mohammadhgh/EVent-ir/Images/v0_1_mit_ir/3D_render_2.jpeg

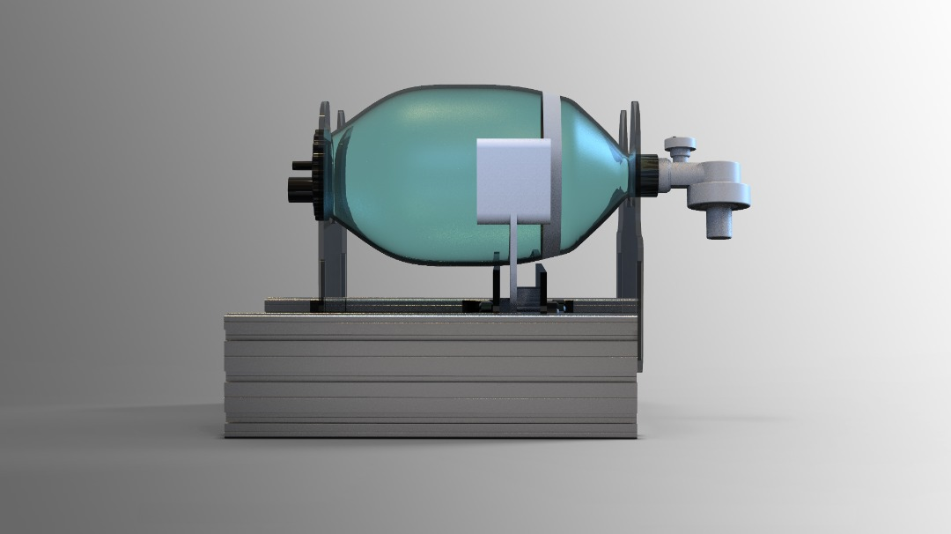
Images/v0_1_mit_ir/3D_render_2.jpeg
