mohammadhgh/EVent-ir/README.md

# EVent-ir
COVID-19 Open Source Emergency Ventilator (ir version)
