mohammadhgh/EVent-ir/Design/ColorPalette.png

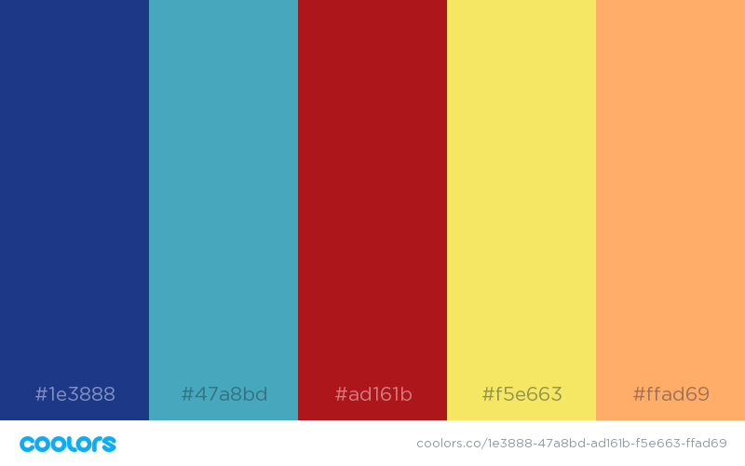
Design/ColorPalette.png
