mohammadhgh/EVent-ir/Mechanical/E-Vent Solidworks v1.0/BOM/BOM.docx

لیست خرید و تخمین قیمت

تعداد | قیمت واحد (ت) | نام قطعه | 1
2 | 78524 | شفت هارد با قطر 12 میلی‌متر طول 62 میلی‌متر (https://www.sanatbazar.com/shop/shop-main/%D8%B4%D9%81%D8%AA-%D9%87%D8%A7%D8%B1%D8%AF-%D8%A8%D8%A7-%D9%82%D8%B7%D8%B1-12-%D9%85%DB%8C%D9%84%DB%8C%D9%85%D8%AA%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) | 2
1 | 66445 | شفت هارد با قطر 12 میلی متر طول 50.5 میلی‌متر (https://www.sanatbazar.com/shop/shop-main/%D8%B4%D9%81%D8%AA-%D9%87%D8%A7%D8%B1%D8%AF-%D8%A8%D8%A7-%D9%82%D8%B7%D8%B1-12-%D9%85%DB%8C%D9%84%DB%8C%D9%85%D8%AA%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) | 3
2 | 37650 | پروفیل آلومینیومی شیاردار 30در90 به طول 300 میلی‌متر (https://www.sanatbazar.com/shop/shop-main/%D9%BE%D8%B1%D9%88%D9%81%DB%8C%D9%84-%D8%A2%D9%84%D9%88%D9%85%DB%8C%D9%86%DB%8C%D9%88%D9%85%DB%8C-30-90) | 4
10 | 7151 | نبشی پروفیل دیواره دار (لچکی دار) بدون پرداخت سطح 30 در 30 و مناسب برای اسلات 8 (https://www.sanatbazar.com/shop/shop-main/%D8%A7%D8%AA%D8%B5%D8%A7%D9%84-%D8%B2%D8%A7%D9%88%DB%8C%D9%87-%D8%AF%D8%A7%D8%B1-angle-connector-%D9%85%D9%86%D8%A7%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) | 5
5 | 25049 | بست شفت مدل RSB با قطر 12 میلی متر (https://www.sanatbazar.com/shop/shop-main/%D8%A8%D8%B3%D8%AA-%D8%B4%D9%81%D8%AA-%D9%85%D8%AF%D9%84-rsb-%D8%A8%D8%A7-%D9%82%D8%B7%D8%B1%D9%87%D8%A7%DB%8C-%D9%8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) | 6
3 | 92843 | چرخ دنده ساده فلنج‌دار مدول 1.5 با تعداد دندانه های 30 (https://www.sanatbazar.com/shop/shop-main/%DA%86%D8%B1%D8%AE%D8%AF%D9%86%D8%AF%D9%87-%D8%B3%D8%A7%D8%AF%D9%87-%D9%81%D9%84%D9%86%D8%AC-%D8%AF%D8%A7%D8%B1-%D9%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) | 7
10 | | پیچ M3x20 و مهره | 8
10 | | پیچ M3x10 و مهره | 9
24 | | پیچ M8x16 و مهره | 10

هزینه ماشین CNC

هزینه خرید ورق آلومینیومی
