mohammadhgh/EVent-ir/Mechanical/E-Vent Solidworks v2.1/E-Vent v2.0.SLDASM

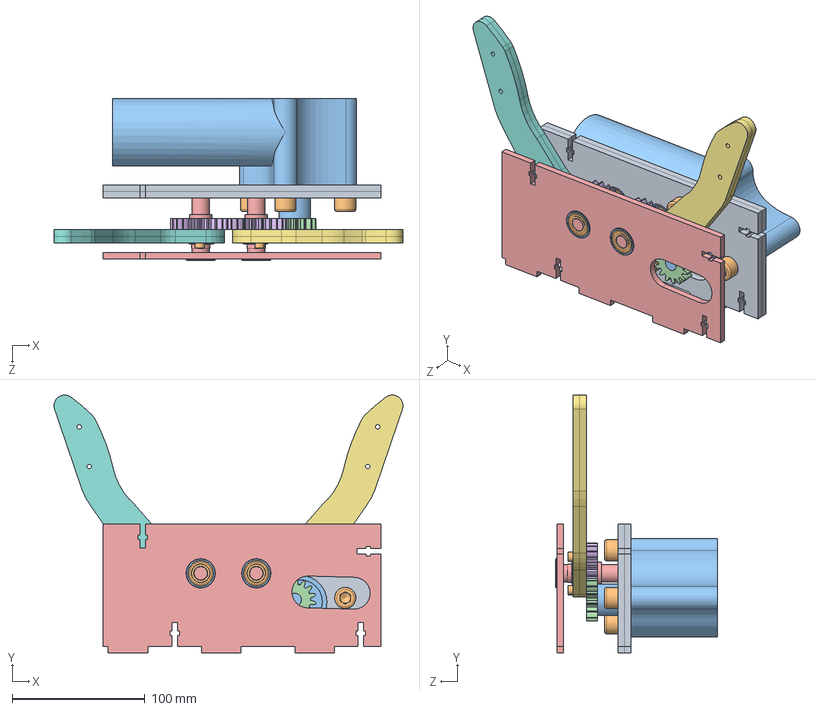
[picture p7: CAD file, 2020-04-24]
Mechanical/E-Vent Solidworks v2.1/E-Vent v2.0.SLDASM
263.1 x 194.3 x 121.8 mm
Motor and Finger Mount v2.0 x 2
_61900_2Z_PART1_2 x 4
_61900_2Z_PART2_4 x 4
_61900_2Z_PART3_6 x 36
shaft 10 mm x 2
ISO - Spur gear 1.9M 22T 20PA 8.4FW ---S22A75H50L14.0N x 2
Finger x 2
Finger 2 x 2
circlip for shafts normal_din x 2
socket head cap screw_iso x 7
Buhler motor
spur gear_iso
Motor and Finger Mount 2 v2.0
