mohammadhgh/EVent-ir/Mechanical/E-Vent Solidworks v2.1/Motor and Finger Mount v2.0.SLDPRT

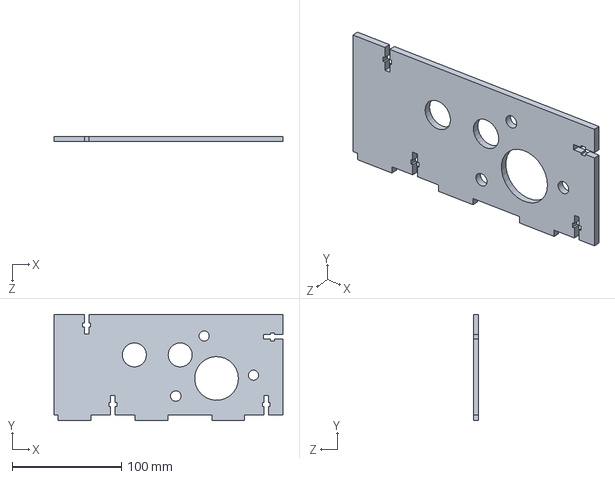
[picture p8: CAD file, 2020-04-24]
Mechanical/E-Vent Solidworks v2.1/Motor and Finger Mount v2.0.SLDPRT
209.5 x 97.0 x 5.00 mm
