mohammadhgh/EVent-ir/Mechanical/E-Vent Solidworks v2.1/Finger 2.SLDPRT

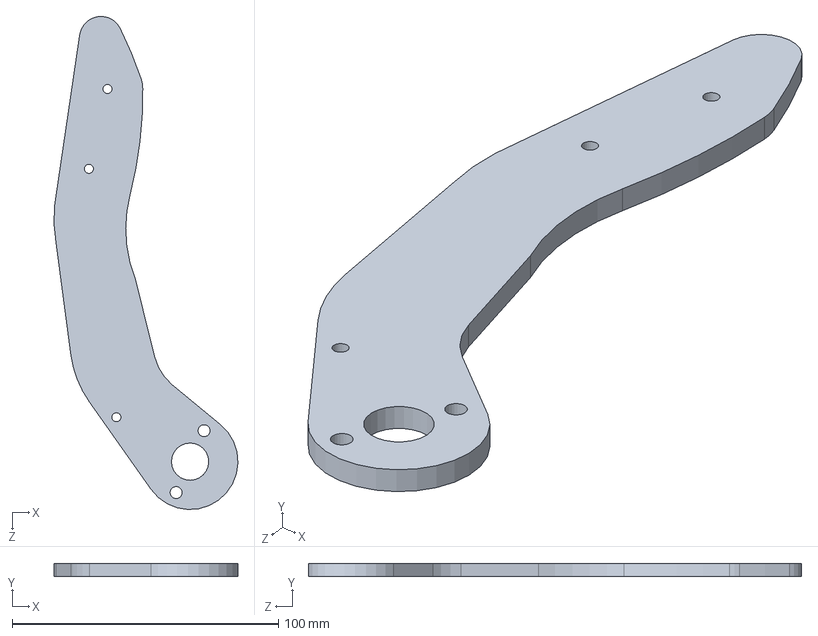
[picture p9: CAD file, 2020-04-24]
Mechanical/E-Vent Solidworks v2.1/Finger 2.SLDPRT
69.1 x 5.00 x 185.2 mm
