mohammadhgh/EVent-ir/Mechanical/E-Vent Solidworks v2.1/shaft 10 mm.SLDPRT

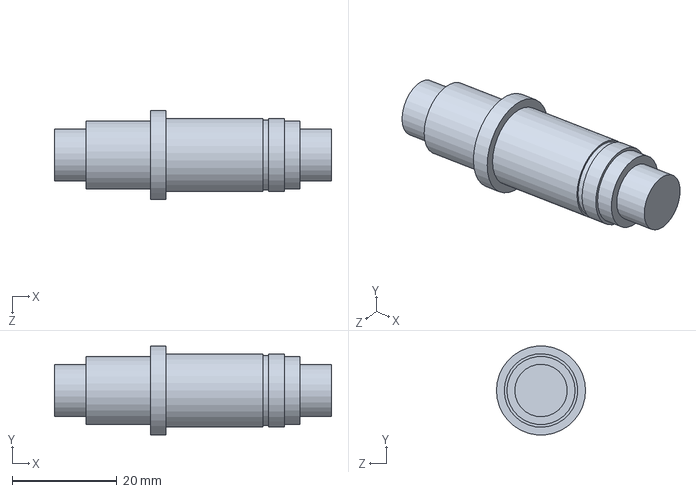
[picture p10: CAD file, 2020-04-24]
Mechanical/E-Vent Solidworks v2.1/shaft 10 mm.SLDPRT
52.8 x 16.9 x 17.0 mm
