mohammadhgh/EVent-ir/Mechanical/E-Vent Solidworks v2.1/Buhler motor.SLDPRT

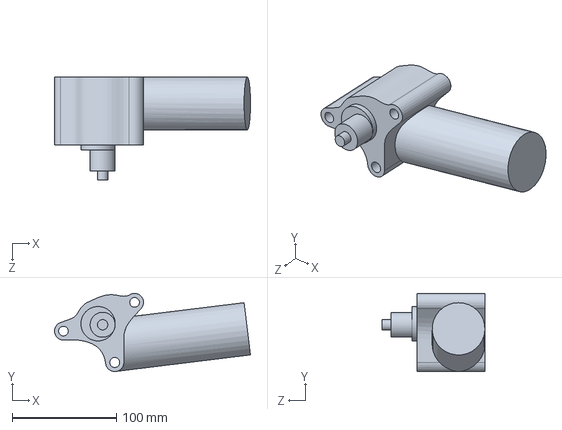
[picture p11: CAD file, 2020-04-14]
Mechanical/E-Vent Solidworks v2.1/Buhler motor.SLDPRT
188.1 x 75.1 x 98.7 mm
