mohammadhgh/EVent-ir/Mechanical/E-Vent Solidworks v2.1/ISO - Spur gear 1.9M 22T 20PA 8.4FW ---S22A75H50L14.0N.SLDPRT

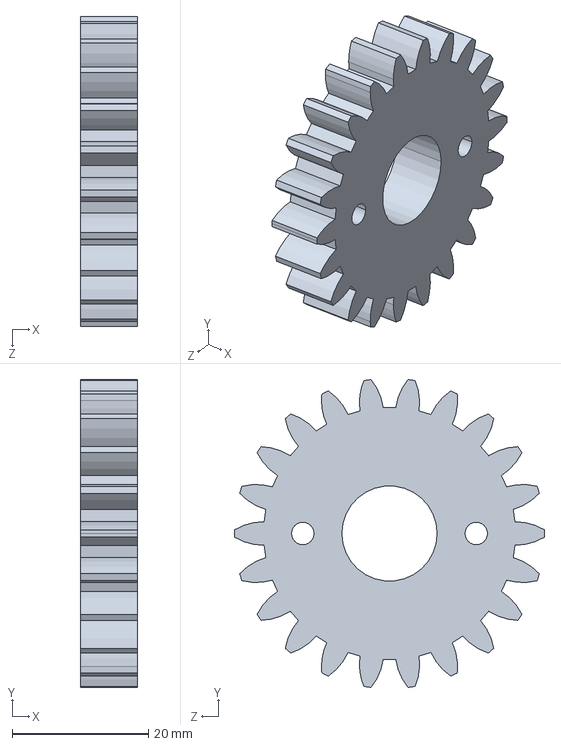
[picture p12: CAD file, 2020-04-14]
Mechanical/E-Vent Solidworks v2.1/ISO - Spur gear 1.9M 22T 20PA 8.4FW ---S22A75H50L14.0N.SLDPRT
8.40 x 45.3 x 45.6 mm
