mohammadhgh/EVent-ir/Mechanical/E-Vent Solidworks v2.0/E-Vent v2.0.SLDASM

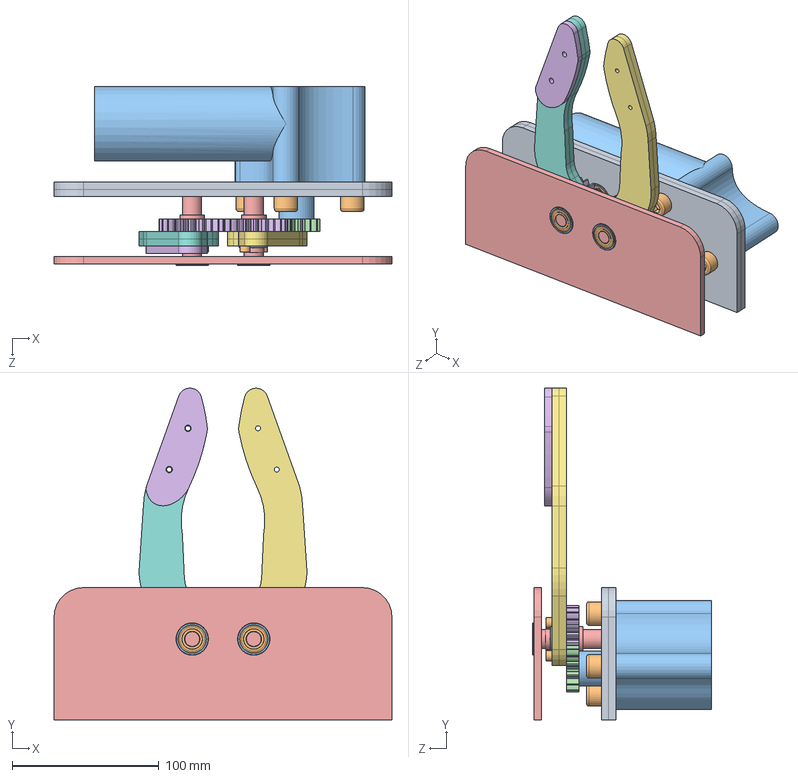
[picture p13: CAD file, 2020-04-24, an earlier design]
Mechanical/E-Vent Solidworks v2.0/E-Vent v2.0.SLDASM
230.0 x 225.7 x 121.8 mm
Motor and Finger Mount v2.0 x 2
_61900_2Z_PART1_2 x 4
_61900_2Z_PART2_4 x 4
_61900_2Z_PART3_6 x 36
shaft 10 mm x 2
ISO - Spur gear 1.9M 22T 20PA 8.4FW ---S22A75H50L14.0N x 2
Finger x 2
Finger 2 x 2
circlip for shafts normal_din x 2
socket head cap screw_iso x 7
Buhler motor
spur gear_iso
Finger tip
