mohammadhgh/EVent-ir/Mechanical/E-Vent Solidworks v1.0/E-Vent.SLDASM

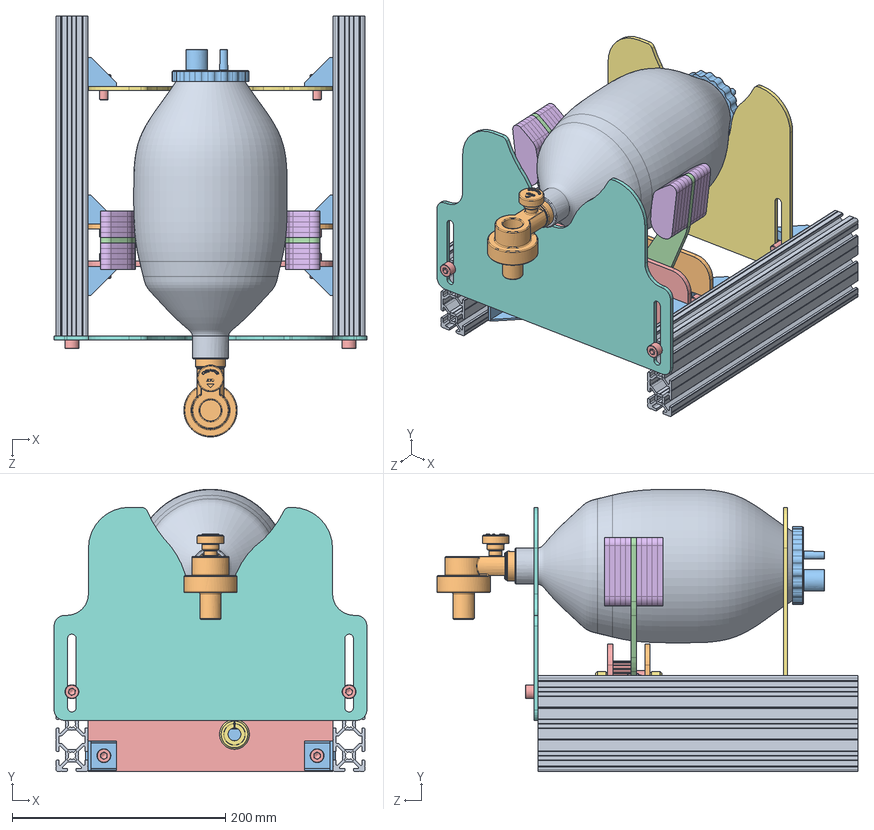
[picture p14: CAD file, 2020-04-07, an earlier design]
Mechanical/E-Vent Solidworks v1.0/E-Vent.SLDASM
293.5 x 264.9 x 394.9 mm
Aluminium Profile 30x90 x 2
Motor and Finger Mount
Aluminium Profile Corner 30x30 x 10
Finger x 2
spur gear_iso x 3
Shaft 12 mm x 2
Shaft Collar 12 mm x 5
Motor
Motor Mount
countersunk flat head cross recess screw_iso x 2
Shaft-coupling 12 mm
socket set screw cone point_iso
Motor and Finger Mount 2
Finger Tip x 20
Bag support
Bag support-fix
AMBU BAG1
ambubag part
butelie 2
Micro Switch- V-156-1C25
socket head cap screw_iso x 19
hex nut style 1 gradeab_iso x 7
