mohammadhgh/EVent-ir/Mechanical/E-Vent Solidworks v1.0/Ambubag2.SLDASM

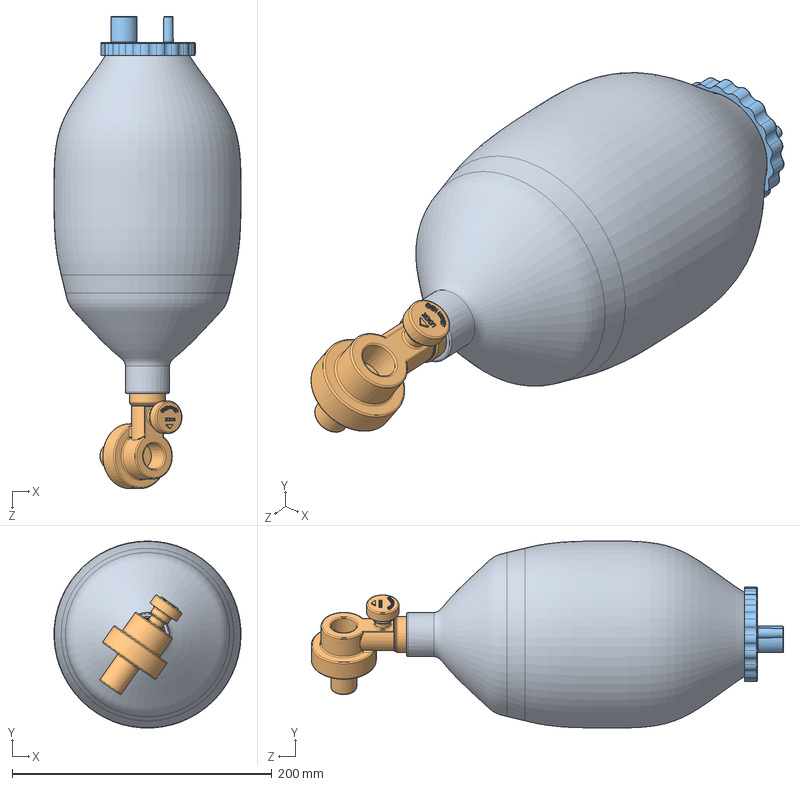
[picture p15: CAD file, 2020-04-05, an earlier design]
Mechanical/E-Vent Solidworks v1.0/Ambubag2.SLDASM
144.0 x 143.9 x 363.7 mm
AMBU BAG1
ambubag part
butelie 2
