mohammadhgh/EVent-ir/Mechanical/E-Vent Solidworks v1.0/E-Vent STEP Files/Motor and Finger Mount.STEP

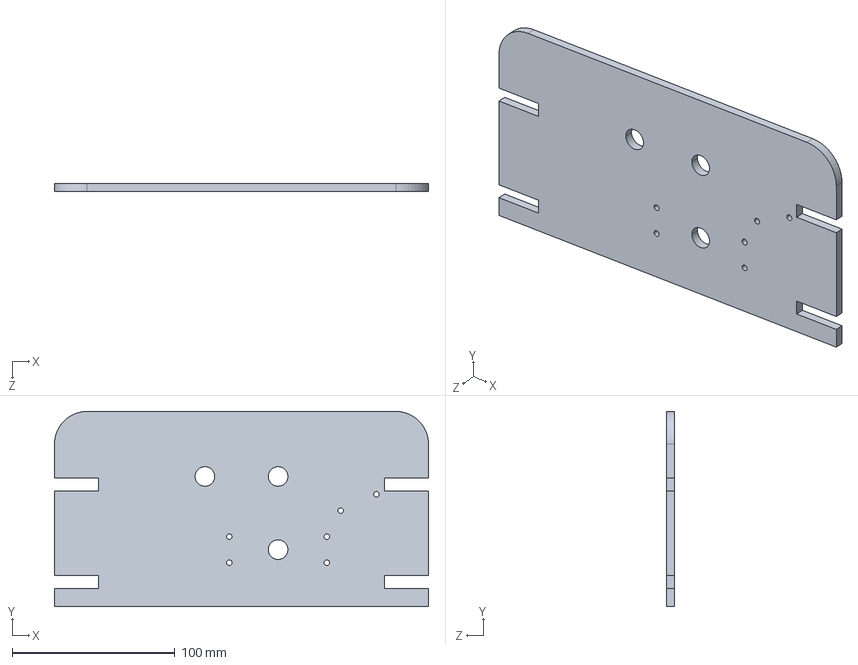
[picture p16: CAD file, 2020-04-07, an earlier design]
Mechanical/E-Vent Solidworks v1.0/E-Vent STEP Files/Motor and Finger Mount.STEP
230.0 x 120.0 x 5.00 mm
