mohammadhgh/EVent-ir/(list of files, cad)

Other CAD files:
Mechanical/E-Vent Solidworks v2.1/Finger.SLDPRT
Mechanical/E-Vent Solidworks v2.1/Motor and Finger Mount 2 v2.0.SLDPRT
Mechanical/E-Vent Solidworks v2.1/_61900_2Z_PART2_4.sldprt
Mechanical/E-Vent Solidworks v2.1/_61900_2Z_PART3_6.sldprt
Mechanical/E-Vent Solidworks v2.1/_61900_2Z_PART1_2.sldprt
Mechanical/E-Vent Solidworks v2.1/61900_2Z.sldasm
Mechanical/E-Vent Solidworks v1.0/Motor and Finger Mount 2.SLDPRT
Mechanical/E-Vent Solidworks v2.0/Buhler motor.SLDPRT
Mechanical/E-Vent Solidworks v1.0/AMBU BAG1.SLDPRT
Mechanical/E-Vent Solidworks v1.0/Aluminium Profile 30x90.SLDPRT
Mechanical/E-Vent Solidworks v1.0/Aluminium Profile Corner 30x30.SLDPRT
Mechanical/E-Vent Solidworks v1.0/Bag support-fix.SLDPRT
Mechanical/E-Vent Solidworks v1.0/Bag support.SLDPRT
Mechanical/E-Vent Solidworks v1.0/E-Vent STEP Files/Bag support-fix.STEP
Mechanical/E-Vent Solidworks v1.0/E-Vent STEP Files/Bag support.STEP
Mechanical/E-Vent Solidworks v1.0/E-Vent STEP Files/Finger Tip X20.STEP
Mechanical/E-Vent Solidworks v1.0/E-Vent STEP Files/Finger X2.STEP
Mechanical/E-Vent Solidworks v1.0/E-Vent STEP Files/Motor Mount.STEP
Mechanical/E-Vent Solidworks v1.0/E-Vent STEP Files/Motor and Finger Mount 2.STEP
Mechanical/E-Vent Solidworks v1.0/Finger Tip.SLDPRT
Mechanical/E-Vent Solidworks v1.0/Finger X2.SLDPRT
Mechanical/E-Vent Solidworks v1.0/Finger.SLDPRT
Mechanical/E-Vent Solidworks v1.0/ISO - Spur gear 1.5M 30T 20PA 17FW ---S30B30H30L12.0N.sldprt
Mechanical/E-Vent Solidworks v1.0/Micro Switch- V-156-1C25.SLDPRT
Mechanical/E-Vent Solidworks v1.0/Motor Mount.SLDPRT
Mechanical/E-Vent Solidworks v1.0/Motor and Finger Mount.SLDPRT
Mechanical/E-Vent Solidworks v1.0/Motor.SLDPRT
Mechanical/E-Vent Solidworks v1.0/Shaft 12 mm.SLDPRT
Mechanical/E-Vent Solidworks v1.0/Shaft Collar 12 mm.SLDPRT
Mechanical/E-Vent Solidworks v1.0/Shaft-coupling 12 mm.SLDPRT
Mechanical/E-Vent Solidworks v1.0/ambubag part.SLDPRT
Mechanical/E-Vent Solidworks v1.0/butelie 2.SLDPRT
Mechanical/E-Vent Solidworks v2.0/61900_2Z.sldasm
Mechanical/E-Vent Solidworks v2.0/Finger 2.SLDPRT
Mechanical/E-Vent Solidworks v2.0/Finger tip.DWG
Mechanical/E-Vent Solidworks v2.0/Finger tip.SLDPRT
Mechanical/E-Vent Solidworks v2.0/Finger.SLDPRT
Mechanical/E-Vent Solidworks v2.0/ISO - Spur gear 1.9M 15T 20PA 8.4FW ---S15A75H50L10.0N.sldprt
Mechanical/E-Vent Solidworks v2.0/ISO - Spur gear 1.9M 22T 20PA 8.4FW.SLDDRW
Mechanical/E-Vent Solidworks v2.0/Motor and Finger Mount 2 v2.0.SLDPRT
Mechanical/E-Vent Solidworks v2.0/Motor and Finger Mount v2.0.DWG
Mechanical/E-Vent Solidworks v2.0/Motor and Finger Mount v2.0.SLDPRT
Mechanical/E-Vent Solidworks v2.0/shaft 10 mm.SLDDRW
Mechanical/E-Vent Solidworks v2.0/shaft 10 mm.SLDPRT
