mohammadhgh/EVent-ir/(threads)

Thread 12 (2020-04-14):

Button multiple hit.

mohammadhgh, 2020-04-14:
When hitting parallel switch with uSwitches, the uSwitch will not work.
