mohammadhgh/EVent-ir/(list of files, drawings)

Other design files:
Design/Fritzing/electronic-system.fzz
PCB/miniVent_PCB_prj/Arduino.SchDoc
PCB/miniVent_PCB_prj/Board_PB_LED.SchDoc
PCB/miniVent_PCB_prj/Buzzer.SchDoc
PCB/miniVent_PCB_prj/ESP32.SchDoc
PCB/miniVent_PCB_prj/esp.PcbLib
PCB/miniVent_PCB_prj/ESP.SchLib
PCB/miniVent_PCB_prj/miniVent.SchLib
PCB/miniVent_PCB_prj/miniVent_PCB_prj.PrjPcb
PCB/miniVent_PCB_prj/Moto_Driver.SchDoc
PCB/miniVent_PCB_prj/Pannel_PB_LED.SchDoc
PCB/miniVent_PCB_prj/Power.SchDoc
PCB/miniVent_PCB_prj/Pressure_Sensor.SchDoc
PCB/miniVent_PCB_prj/Top.SchDoc
PCB/miniVent_PCB_prj/Volume.SchDoc
