mohammadhgh/EVent-ir/(commit log)

2020-04-01 initial fritzing model. 990113
    [electronic-system.fzz]
2020-04-01 mechanical CAD
2020-04-02 Added Motor Controller Code
    [configuration.h]
2020-04-04 SOLIDWORKS files - designed based on the availabilities in IRAN
    [Aluminium Profile 30x90.SLDPRT, Aluminium Profile Corner 30x30.SLDPRT, E-Vent.SLDASM, E-Vent.STEP, Finger Tip.SLDPRT, Finger.SLDPRT, Finger.STEP, ISO - Spur gear 1.5M 30T 20PA 17FW ---S30B30H30L12.0N.sldprt]
2020-04-05 cleaned motor code
    [configuration.h]
2020-04-05 Modifications - bolts and nuts, placementr of Ambu bag
    [AMBU BAG1.SLDPRT, Aluminium Profile Corner 30x30.SLDPRT, Ambubag2.SLDASM, Bag support-fix.SLDPRT, Bag support.SLDPRT, E-Vent.SLDASM, Finger Tip.SLDPRT, Finger.SLDPRT]
2020-04-07 slight modifications, step files, render
    [Aluminium Profile 30x90.SLDPRT, Bag support-fix.SLDPRT, Bag support-fix.STEP, Bag support.STEP, E-Vent.SLDASM, E-Vent.STEP, Finger Tip X20.STEP, Finger Tip.SLDPRT]
2020-04-08 Added Uno Configuration.
    [electronic-system.fzz]
2020-04-08 Buzzer added. (beep)
    [configuration.h]
2020-04-10 Button, LED, Motor, ....
    [configuration.h]
2020-04-11 mid changing to polling.
    [configuration.h]
2020-04-12 Button check is OK.
    [configuration.h]
2020-04-14 mid motor drive nad sysconfig.
    [configuration.h]
2020-04-17 Initial Open State added, OnOff Stat Added to Button Inhale Exhale Time Calc Added to Sys Config
2020-04-18 Motor Driver Changes Inhale Exhale now.
2020-04-18 Potentiometer revised
    [configuration.h]
2020-04-18 Potentiometer Added and Merged to the project
    [configuration.h]
2020-04-18 encoder RPM is OK.
    [configuration.h]
2020-04-19 glcd Bugs Fixed and successfully combined with Pot.
    [configuration.h]
2020-04-20 Motor come and retrun is ok. TODO: anlgle control
2020-04-20 pwm to rpm measurement
2020-04-21 Motor check is back on the loop
2020-04-21 LCD hanging problem solved
    [LCD.cpp, main.cpp]
2020-04-22 Initial PCB commit
    [miniVent.DWG, miniVent.SchDoc, miniVent_Power.PrjPcb]
2020-04-24 v2.1, final fine modifications
    [61900_2Z.sldasm, Buhler motor.SLDPRT, E-Vent v2.0.SLDASM, Finger 2.SLDPRT, Finger tip.DWG, Finger tip.SLDPRT, Finger.SLDPRT, ISO - Spur gear 1.9M 22T 20PA 8.4FW ---S22A75H50L14.0N.SLDPRT]
2020-04-25 mid PCB design.
    [Arduino.SchDoc, Board_PB_LED.SchDoc, Moto_Driver.SchDoc, Pannel_PB_LED.SchDoc, Power.SchDoc, Top.SchDoc, Volume.SchDoc, miniVent.DWG]
2020-04-25 power and opto updated.
    [Arduino.SchDoc, Board_PB_LED.SchDoc, Moto_Driver.SchDoc, Pannel_PB_LED.SchDoc, Power.SchDoc, Top.SchDoc, Volume.SchDoc, miniVent_PCB_prj.PrjPcb]
2020-04-27 mid PCB, connectors OK.
    [ESP32.SchDoc, Moto_Driver.SchDoc, Power.SchDoc, Top.SchDoc, miniVent_PCB_prj.PrjPcb]
2020-04-29 schematic almost done! 990210
    [Arduino.SchDoc, Buzzer.SchDoc, Moto_Driver.SchDoc, Pressure_Sensor.SchDoc, Top.SchDoc, miniVent_PCB_prj.PrjPcb]
2020-04-30 arduino sheet updated.
    [Arduino.SchDoc, Board_PB_LED.SchDoc, ESP32.SchDoc, Moto_Driver.SchDoc, Power.SchDoc, Pressure_Sensor.SchDoc, Top.SchDoc]
2020-05-01 schematic done. start PCB.
    [Arduino.SchDoc, Board_PB_LED.SchDoc, ESP.SchLib, ESP32.SchDoc, Moto_Driver.SchDoc, Pannel_PB_LED.SchDoc, Power.SchDoc, Pressure_Sensor.SchDoc]
2020-05-02 placement is started.
    [Arduino.SchDoc, Board_PB_LED.SchDoc, ESP32.SchDoc, Moto_Driver.SchDoc, Pannel_PB_LED.SchDoc, Power.SchDoc, Pressure_Sensor.SchDoc, Top.SchDoc]
2020-05-05 PCB placement locally OK.
    [Top.SchDoc, miniVent_PCB_prj.PrjPcb]
2020-05-05 mid placement. new dxf
    [Moto_Driver.SchDoc, Top.SchDoc]
2020-05-06 mid placement.
    [Arduino.SchDoc, Top.SchDoc, miniVent_PCB_prj.PrjPcb]
2020-05-08 mid placement!
    [Arduino.SchDoc, Top.SchDoc, miniVent_PCB_prj.PrjPcb]
2020-05-09 ROUTING STARTED.
    [Arduino.SchDoc, Moto_Driver.SchDoc, Power.SchDoc, Top.SchDoc, miniVent_PCB_prj.PrjPcb]
2020-05-11 mid signal routing. power not done.
    [Arduino.SchDoc, Moto_Driver.SchDoc, Power.SchDoc, Top.SchDoc, miniVent_PCB_prj.PrjPcb]
2020-05-12 routing is OK
    [Arduino.SchDoc, Moto_Driver.SchDoc, Top.SchDoc]
2020-05-15 routing is done!
    [Arduino.SchDoc, miniVent_PCB_prj.PrjPcb]
2020-05-15 DRC almost finished!
    [Moto_Driver.SchDoc, Top.SchDoc, Volume.SchDoc, miniVent_PCB_prj.PrjPcb]
2020-05-15 kowsar sent.
    [Arduino.SchDoc, Pressure_Sensor.SchDoc, Top.SchDoc]
